ee24s046-alt/stm32-ads1256-daq/docs/img/dsp-demo.png

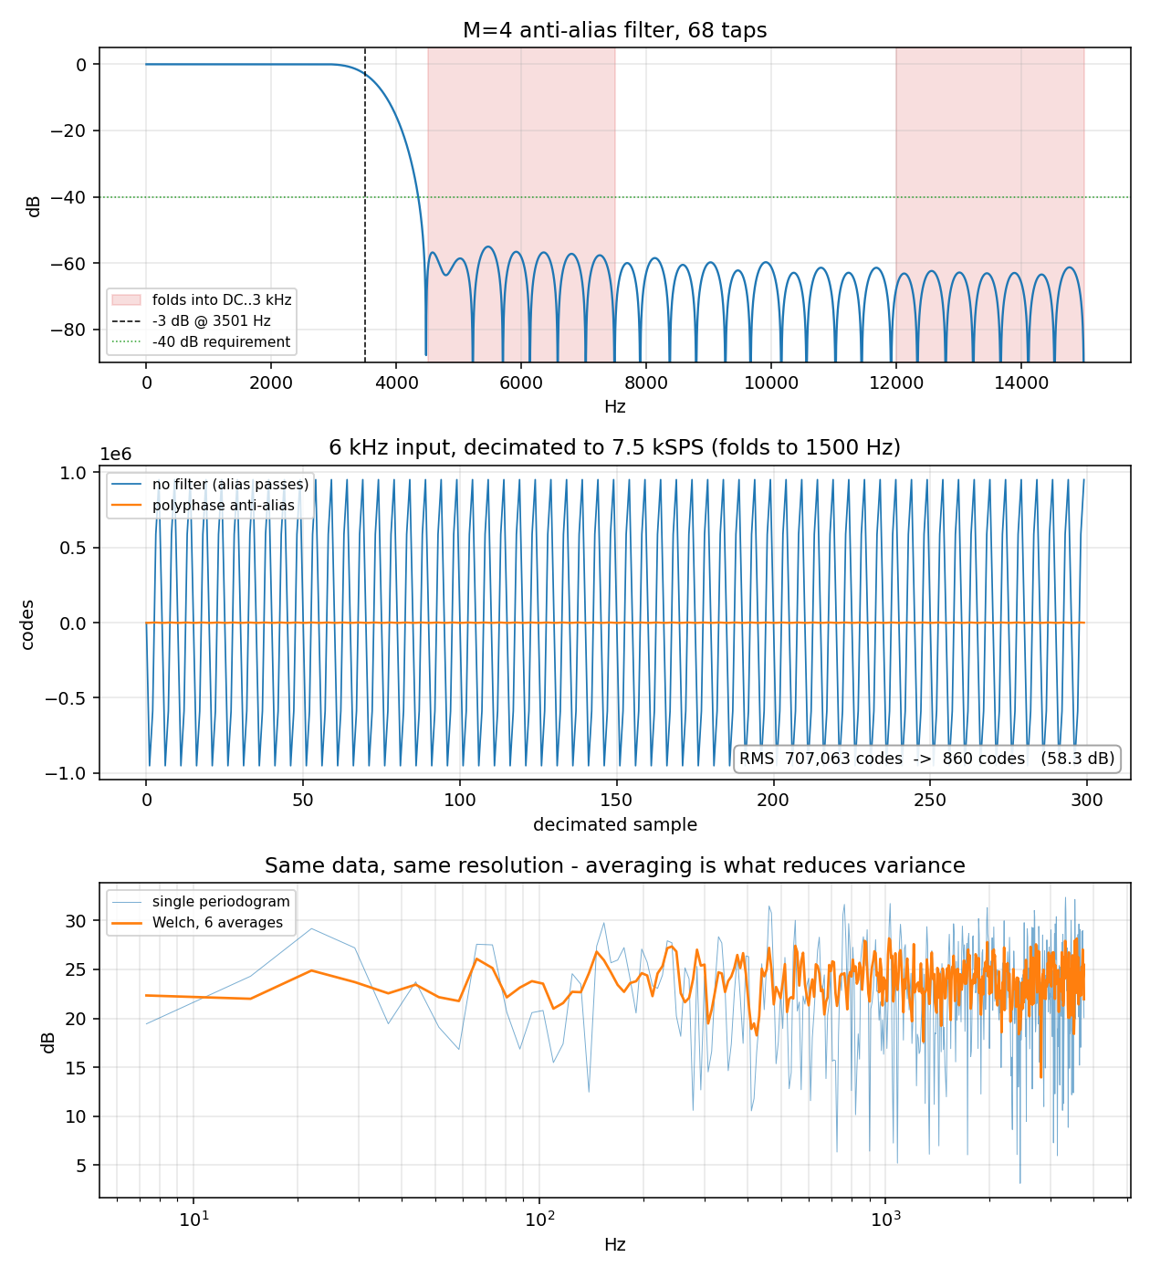
docs/img/dsp-demo.png
