ee24s046-alt/stm32-ads1256-daq/(commit log)

2026-06-02 build: bare-metal scaffold for STM32F407, no vendor HAL
    Hand-written Cortex-M4 core and STM32F4 peripheral definitions from the ARMv7-M
    ARM and RM0090 rather than a CMSIS pack, so the tree is self-contained and every
    register touched is one this project actually uses.
    Linker script carves flash sector 11 out of FLASH into its own CALSTORE region,
    so the linker physically cannot place code where the calibration writer erases.
2026-06-05 core: 168 MHz clock tree with bounded waits, polled UART, DWT/TIM2 timebases
    Every RCC wait loop is bounded. A dead HSE now falls back to HSI and reports the
    stage it failed at, instead of hanging before main() with no output at all.
    Two timebases on purpose: DWT->CYCCNT (5.95 ns) for profiling only, since it
    wraps every 25.6 s, and TIM2 (1 MHz, 32-bit) as the sole source of packet
    timestamps.
2026-06-11 lib: lock-free SPSC ring buffer
    Producer owns head, consumer owns tail, correctness from two release/acquire
    fences rather than from masking interrupts. xQueueSendFromISR would take the
    scheduler critical section on a path with a 133 us hard deadline.
    Free-running indices with a power-of-two mask, so full is (head - tail) ==
    capacity and the 2^32 wrap is well defined.
2026-06-14 proto: 24-byte binary frame with CRC-16 and a real resync path
    Framing is sync AND version AND CRC. 0xA5 0x5A occurs in 24-bit sample data
    about once every 65 kB, so a receiver that trusts the sync word alone will lock
    onto noise within minutes.
    Timestamp is taken in the ISR, not at packetisation, so scheduling jitter shows
    up as delivery latency and never as error in the data.
2026-06-20 drivers: ADS1256 over bare-metal SPI1, every register verified by read-back
    SCLK at 1.3125 MHz (APB2/64). The /32 option gives 2.625 MHz against a 1.92 MHz
    limit and mostly works, which is worse than failing - hence the read-back checks
    and the STATUS.ID identity check at init.
    Channel cycling uses TI's documented RDATA / WREG MUX / SYNC / WAKEUP sequence
    inside a single CS window. Note this yields 7500 settled conversions per second,
    not 30000: the sinc filter's settling time at DRATE = 30 kSPS is 0.13 ms.
2026-06-27 cal: Q16.16 two-point correction persisted to an append-only flash log
    Fixed point rather than float so the processor task never triggers lazy FPU
    context stacking. int64 intermediate because the product needs 40 bits; a 32-bit
    multiply truncates silently near full scale.
    Sector 11 holds 2048 x 64-byte slots. A save programs the next blank slot with
    no erase, so losing power mid-save costs only the record being written - the
    boot scan skips the bad CRC and falls back. Erase only happens when the log
    fills, and invalidates the ART data cache afterwards.
2026-07-04 usb: OTG_FS device stack and CDC-ACM, written to the registers
    FIFO budget accounts for all 320 words of core RAM; an overlap here is silent
    and shows up as corruption on whichever endpoint got clipped.
    Two details that cost time: SET_ADDRESS must program DCFG before the status
    stage on this core, and DIEPTSIZ.PKTCNT is the number of max-packet-size
    packets, not 1 - getting it wrong strands 320 bytes in the FIFO.
    Serial number derived from the 96-bit unique device ID so two boards on one host
    do not collide.
2026-07-12 rtos: three-stage pipeline, fully static, with a fault handler that diagnoses
    configSUPPORT_DYNAMIC_ALLOCATION = 0 and no heap_*.c is linked, so an accidental
    pvPortMalloc breaks the build rather than the device.
    Priorities are rate-monotonic, not ordinal: sampler 4 (133 us deadline),
    processor 3, uplink 2, housekeeping 1. The DRDY ISR only latches TIM2 and
    notifies; the 61 us SPI transaction runs in a preemptible task so it can never
    mask the USB core.
    Fault handlers decode CFSR/HFSR and print MMFAR/BFAR only when their VALID bits
    are set, and halt rather than reset so the RAM survives for a debugger.
2026-07-18 test: native unit tests over the portable core, ASan + UBSan
    These link the same firmware/lib/*.c the image links, so a bug fixed here is
    fixed in the image. Covers the cases that cannot be reached on target: the ring
    index wrapping past 2^32 (about six days of continuous streaming), bulk drain
    across the wrap, exhaustive single-bit corruption of every frame, and framing
    against a payload that deliberately contains the sync word.
2026-07-25 host: decoder, capture tool, noise analysis and CLI
    protocol.py is an independent re-implementation of packet.c checked against the
    same golden vector, which is what catches the two drifting apart.
    Loss is proven from the wire by three independent checks - sequence continuity,
    timestamp continuity and the device's own flag bits - rather than trusting a
    firmware counter that could be wrong in the same way the firmware is.
    Built-in simulator can inject gaps and bit corruption, so the resync and
    loss-detection paths are exercised by the same code that handles real data.
2026-08-02 docs: architecture, timing budget, protocol, calibration, measured results
    Each deadline is derived from a datasheet or clock constant first, then measured
    with DWT->CYCCNT - a measurement with no prediction to check it against is just
    a number. Every figure in measured-results.md states the command that
    reproduces it.
2026-08-08 docs: evidence checklist, hardware documentation, reference-capture scaffolding
    Every headline number in the README is a measurement, so each one now names the
    artifact that backs it: a stats dump, two logic-analyser captures with cursors,
    the noise plot, and a 10 s reference capture committed to the repo so a reader
    can re-derive the figures from real data rather than taking them on trust.
    measured-results.md now states plainly that a figure is a prediction until its
    evidence item is ticked.
    hardware/ covers both cases - an off-the-shelf ADS1256 module, where what is
    needed is an interconnect drawing, and an own-design front end, where the
    schematic and the reference/filter/grounding note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
2026-08-20 dsp: wideband mode, polyphase decimation, Welch PSD and THD+N on-device
    Adds the signal-processing half of the project. Three pieces, all in the
    portable core so the native tests exercise the code that ships.
    WIDEBAND MODE. Parking the multiplexer removes the ADS1256's 4-period sinc
    settling penalty, so every conversion is usable: 30 kSPS with /DRDY every
    33.3 us instead of 133. The driver uses RDATAC there (3 bytes) rather than RDATA
    (4) because the budget has 6.5 us of slack after the mandatory t6 delay. The
    sampler runs at 80 % of its deadline in this mode against 46 % in the muxed one
    - which is why it is a mode and not the default.
    This is also the only regime in which the DSP numbers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
2026-09-10 host: add 'ads1256 plot' for captured signal traces
    The tooling could characterise a shorted input and verify a capture lost
    nothing, but had no way to simply draw what the instrument recorded. That is
    the one plot a reviewer from outside firmware actually understands, and the
    only artifact that shows the device doing its job rather than merely working.
    Takes per-channel labels and scale factors so traces come out in mmHg or
    mL/min rather than volts, and an optional --loop pair for an X-Y plot - a
    pressure-diameter loop being the scientific output the instrument exists for.
    The time axis is built from the device's t_us timestamps with the TIM2 32-bit
    rollover unwrapped, not from the sample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
